koptserg/motion/README.md

# How to join:
### If device in FN(factory new) state:
1. Press and hold button (1) for 2-3 seconds, until device start flashing led
2. Wait, in case of successfull join, device will flash led 5 times
3. If join failed, device will flash led 3 times

### If device in a network:
1. Hold button (1) for 10 seconds, this will reset device to FN(factory new) status
2. Go to step 1 for FN device

# Hardware
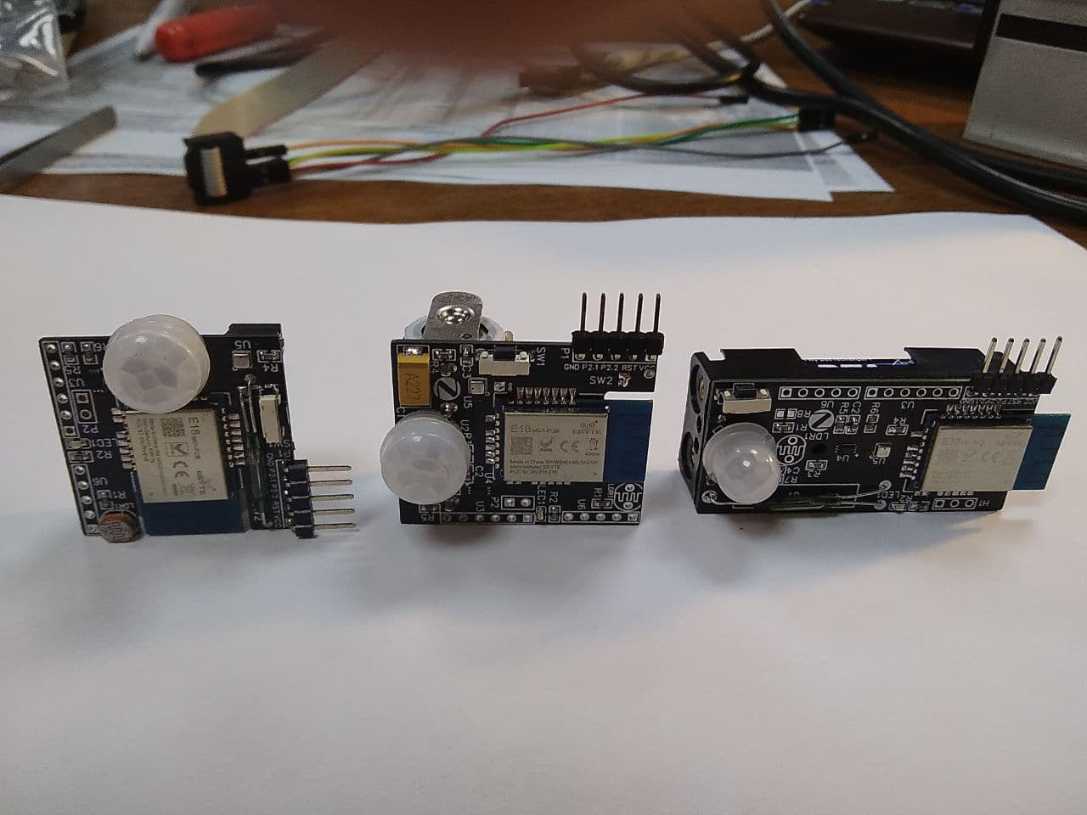
[picture p1: images/photo_2021-07-11_18-00-41.jpg]

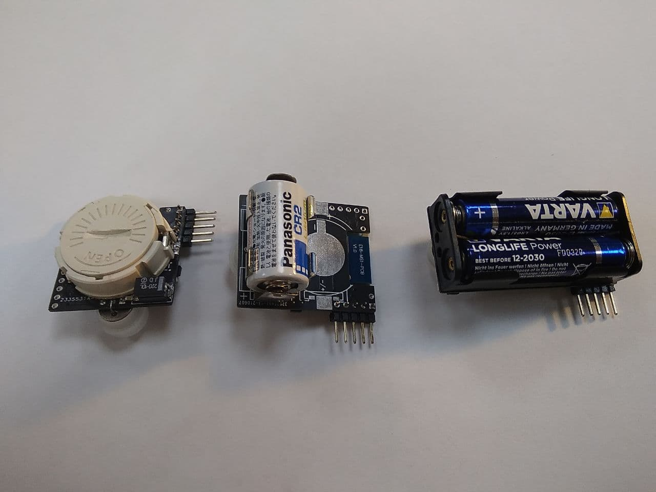
[picture p2: images/photo_2021-07-11_18-02-03.jpg]

### 2AAA version
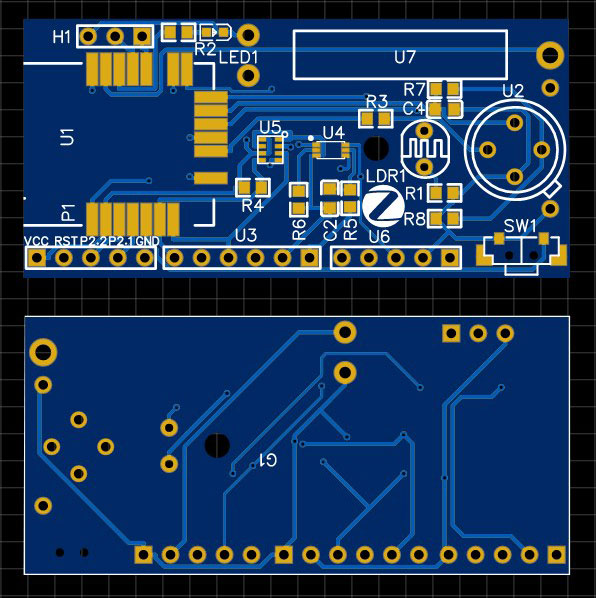
[picture p3: images/motion_AAA.jpg]

- Gerber, BOM, Scheme [2AAA](hardware/AAA/)

### CR2 version
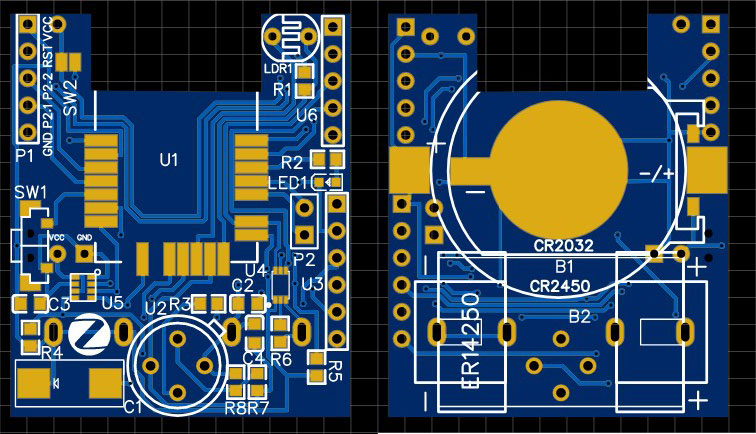
[picture p4: images/motion_CR2.jpg]

- Gerber, BOM, Scheme [CR2](hardware/CR2/)
- Attention! Do not use CR2032 and CR2450 with a motion sensor (AM312 / BS312), as at low battery voltage (<3v) false alarms occur.

# Firmwares
- Downalod from github [releases](https://github.com/koptserg/motion/releases)

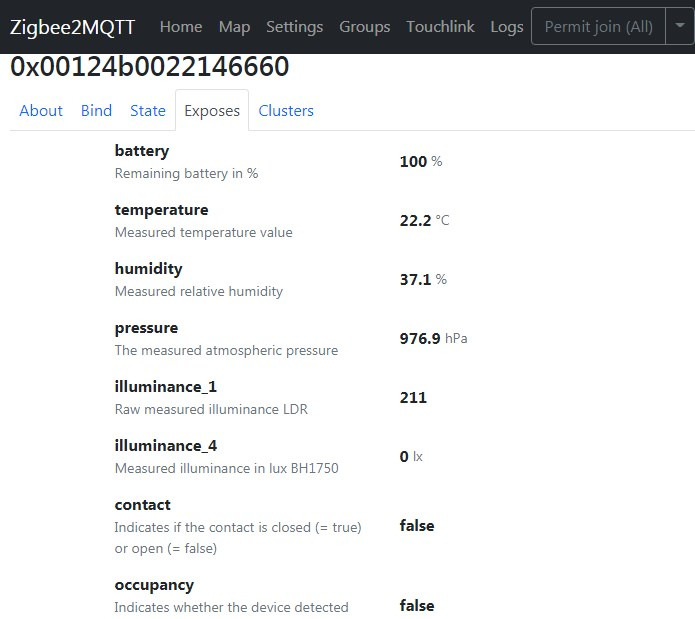
[picture p5: images/diyruz_motion_1.jpg]

- Settings can be changed without restarting zigbee2mqtt
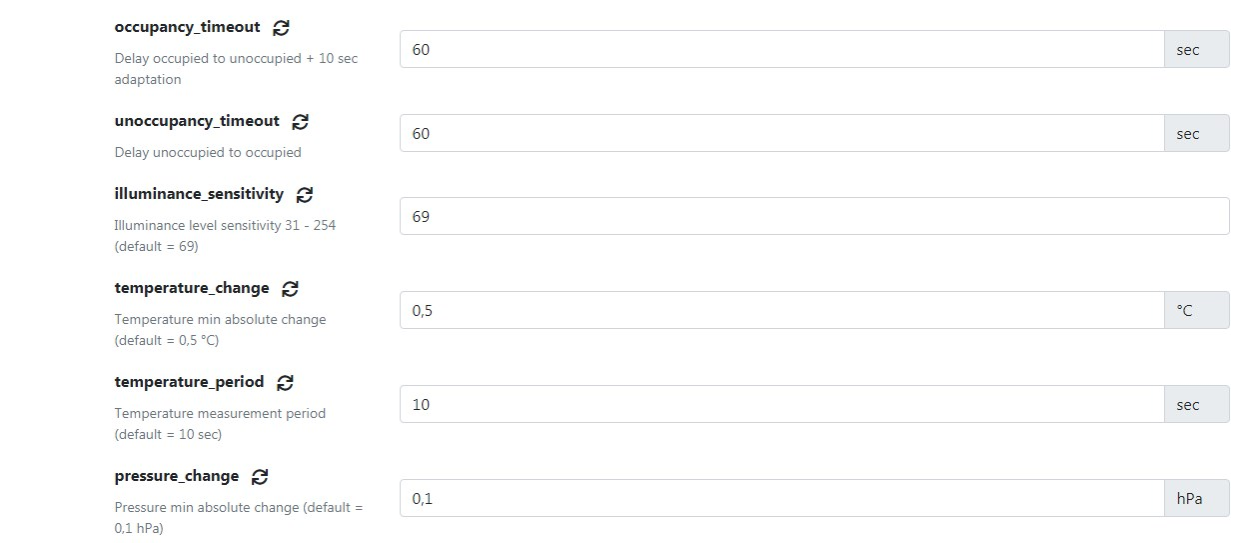
[picture p6: images/diyruz_motion_2.jpg]

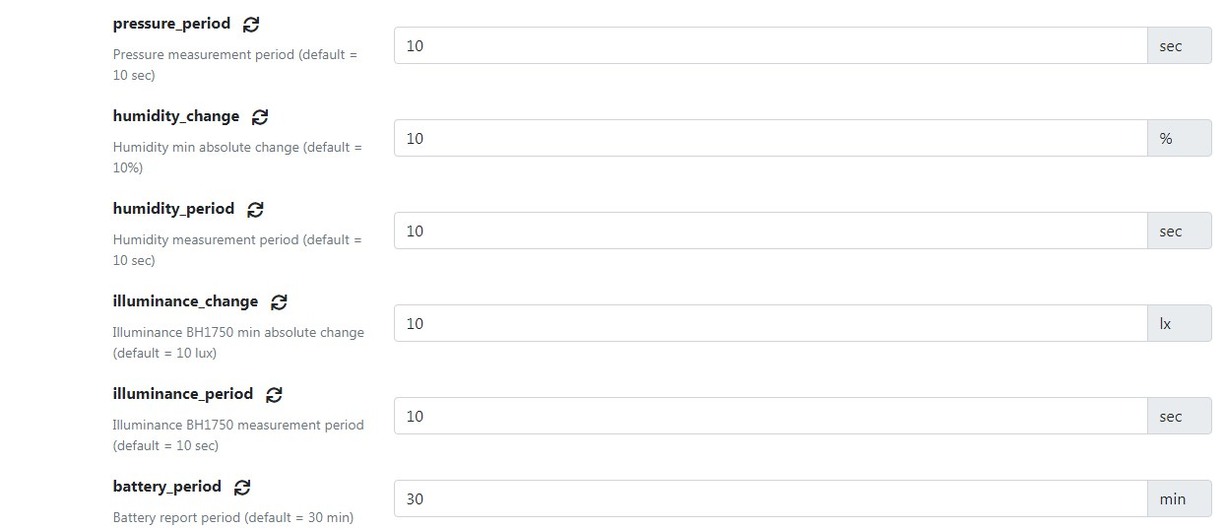
[picture p7: images/diyruz_motion_3.jpg]

- Bind
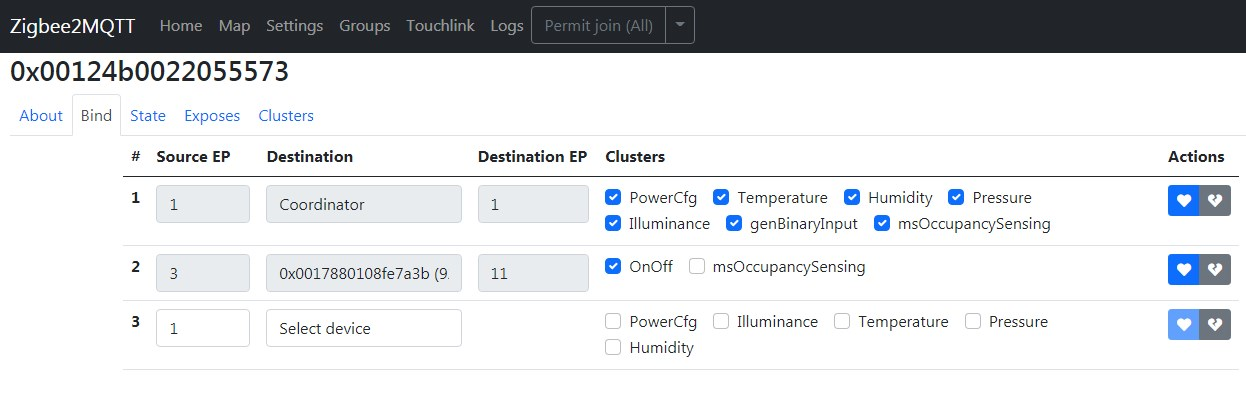
[picture p8: images/diyruz_motion_4.jpg]


- [Converters](converters/)

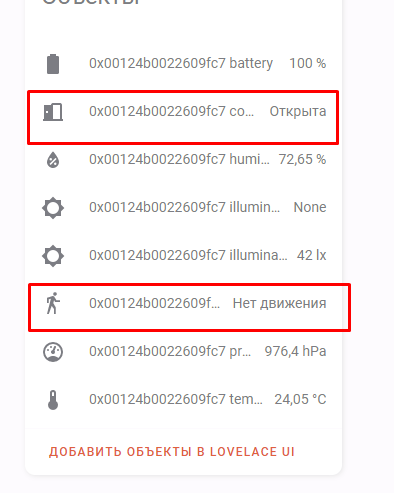
[picture p9: images/diyruz_motion_5.png]


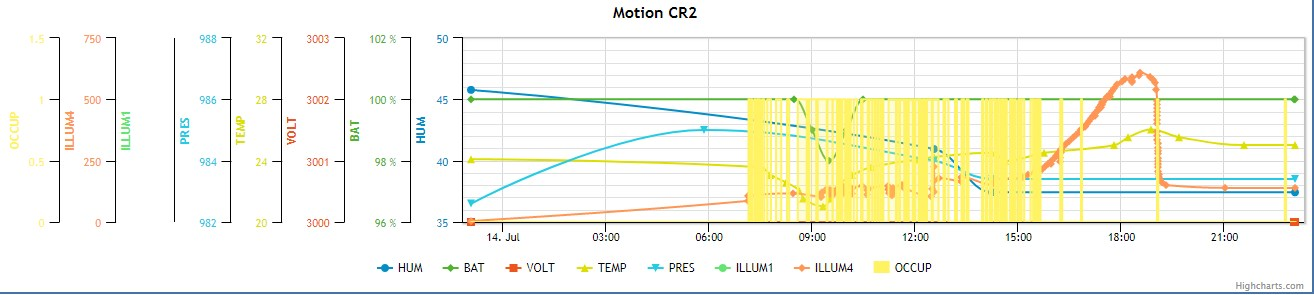
[picture p10: images/diyruz_motion_6.jpg]


# Thanks for the help
- firmware github [diyruz](https://github.com/diyruz) by [@anonymass](https://t.me/anonymass)
- hardware and testing by [@ring04](https://t.me/ring04)
- telegram channel [Zigdev](https://t.me/zigdev)
