koptserg/motion/images/diyruz_motion.jpg

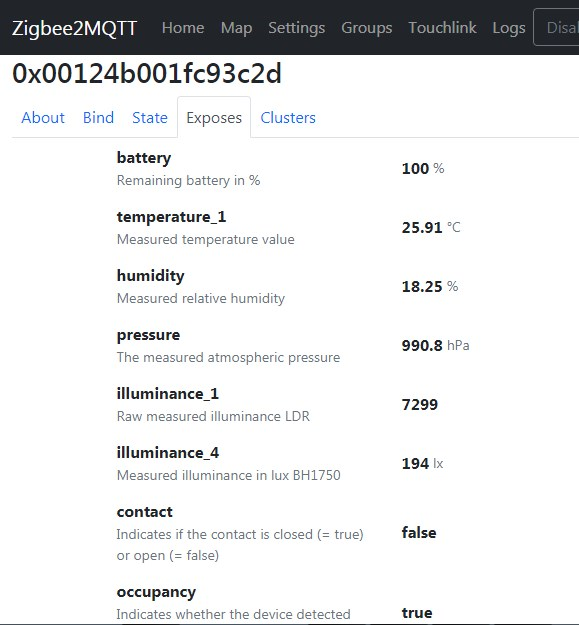
images/diyruz_motion.jpg
