koptserg/motion/images/diyruz_motion_sheme.jpg

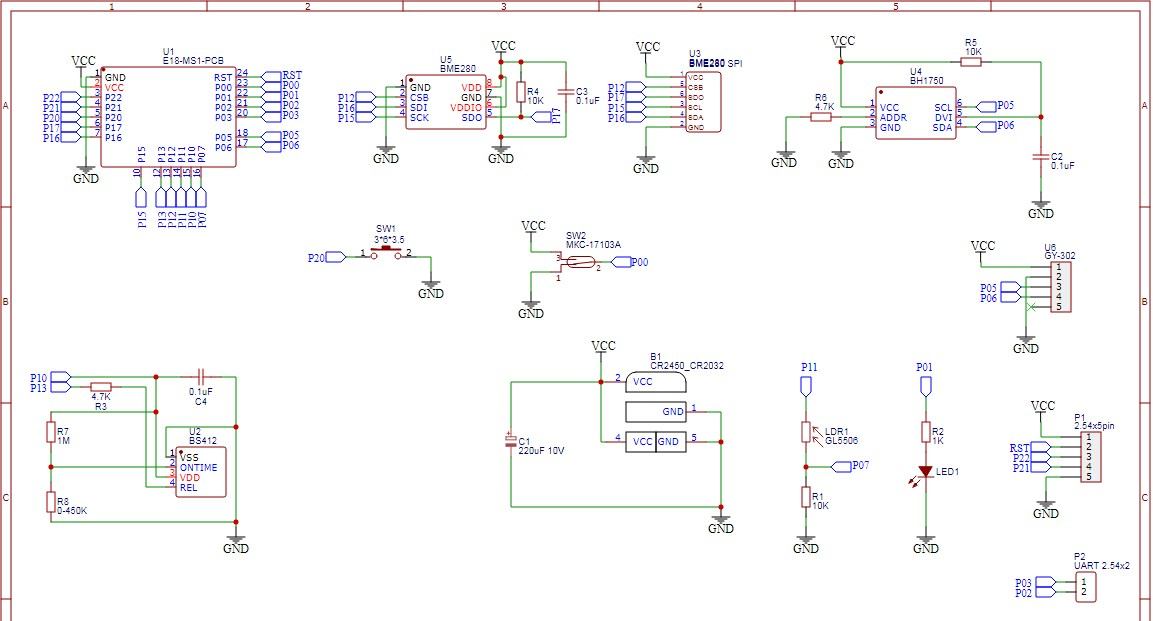
images/diyruz_motion_sheme.jpg
