koptserg/motion/hardware/CR2/BOM_zigbee_multipurpose_sensor_cr2450_v4.2_CR2_2021-07-14.csv

ID | Name | Designator | Footprint | Quantity | Manufacturer Part | Manufacturer | Supplier | Supplier Part | Price
1 | ER14250 BC-0301 AA/2 | B2 | BC-0301 ER14250 | 1 | BC-0301 |  | COMF |  |  | https://aliexpress.ru/item/33048790245.html
2 | МКС-17103А | SW2 | МКС-17103А-1 | 1 | МКС-17103А |  |  |  |  | https://aliexpress.ru/item/4000079749342.html
3 | 220uF 10V | C1 | EIA7343-31/D-W | 1 | TPSD227M010R0100 | AVX | LCSC | C8028 | 0.9161
4 | BS412 | U2 | SENSOR-TH_BS412 | 1 | BS412 | Senba Sensing Tech | LCSC | C410378 | 1.4066 | https://aliexpress.ru/item/1005002690374706.html https://aliexpress.ru/item/1005001706665504.html
5 | 0.1uF | C4,C3 | C0603 | 2 | 0603CG0R5C500NT | FH | LCSC | C1633 | 0.0044
6 | UART 2.54x2 | P2 | HDR-F-2.54_1X2 | 1 | 2.54x2pin | 2.54x2pin | LCSC | C49661 | 0.0336
7 | BH1750 | U4 | BH1750 SMT | 1 | BH1750FVI-TR | ROHM | LCSC | C78960 | 0.9433 | https://aliexpress.ru/item/4001146064858.html
8 | 0.1uF | C2 | C0603 | 1 | 0603CG0R5C500NT | FH | LCSC | C1633 | 0.0044
9 | 2.54x5pin | P1 | CC2530 TTL | 1 | 2.54x5pin | ReliaPro |  | C28952 | 0.0535
10 | GY-302 | U6 | BH1750 | 1 | 2.54x5pin | ReliaPro |  | C28952 | 0.0535
11 | 1K | R2 | R0603 | 1 | R0603RXX102XF10LTS | Shenzhen Eyang Tech Development | LCSC | C267568 | 0.0019
12 | 3*6*3.5 | SW1 | SW 3X6X2017MM SMT | 1 | 3*6*3.5 Side press High temperature | ReliaPro | LCSC | C37327 | 0.041 | https://aliexpress.ru/item/32816626751.html
13 | BME280 | U3 | BME280 | 1 | 2.54x6pin | 2.54x6pin
14 | 4.7K | R3,R6 | R0603 | 2 | R0603RXX472XJ10LTS | Shenzhen Eyang Tech Development | LCSC | C267283 | 0.0016
15 | BME280 | U5 | LGA-8_BME280 | 1 | BME280 | Bosch | LCSC | C92489 | 5.8852 | https://aliexpress.ru/item/1005002976067537.html
16 | E18-MS1-PCB | U1 | E18-MS1-PCB | 1 | E18-MS1-PCB | Chengdu Ebyte Elec Tech | LCSC | C97344 | 3.6733 | https://aliexpress.ru/item/4000185268806.html
17 | 10K | R1,R5,R4 | R0603 | 3 | AC0603FR-0710KL | YAGEO | LCSC | C116677 | 0.0022
18 | GL5506 | LDR1 | RES-PHOTO_CDS | 1 | GL5506(4-7K) | JCHL(Shenzhen Jing Chuang He Li Tech) | LCSC | C404970 | 0.047 | https://aliexpress.ru/item/32382661279.html
19 | 1M | R7 | R0603 | 1 | R0603RXX472XJ10LTS | Shenzhen Eyang Tech Development | LCSC | C267283 | 0.0016
20 | 0-450K | R8 | R0603 | 1 | R0603RXX472XJ10LTS | Shenzhen Eyang Tech Development | LCSC | C267283 | 0.0016
21 | HQ17-2102UBC | LED1 | LED0603-RD | 1 | HQ17-2102UBC | HARVATEK | LCSC | C154491 | 0.0256
22 | CR2450_CR2032 | B1 | CR2450_CR2032 | 1 | BS-8-1 | Q&J | LCSC | C70378 | 0.2722 | https://aliexpress.ru/item/33035019425.html https://aliexpress.ru/item/1005002322640119.html
