koptserg/motion/(threads)

Thread 1 (2021-05-05):

hardware

sergge1, 2021-05-05:
hello. your project is very interesting. what is abut hardware? have you built the PCB for this sproject?

koptserg, 2021-05-06:
The printed circuit board is designed for AM312, but gives false alarms on a dead 2450 battery. We will try sensors BS312 and BS412 or go to 2xAAA.

koptserg, 2021-05-06:
> hello. your project is very interesting. what is abut hardware? have you built the PCB for this sproject?

The printed circuit board is designed for AM312, but gives false alarms on a dead 2450 battery. We will try sensors BS312 and BS412 or go to 2xAAA.

koptserg, 2021-07-15:
> > hello. your project is very interesting. what is abut hardware? have you built the PCB for this sproject?
>
> The printed circuit board is designed for AM312, but gives false alarms on a dead 2450 battery. We will try sensors BS312 and BS412 or go to 2xAAA.

> hello. your project is very interesting. what is abut hardware? have you built the PCB for this sproject?

https://github.com/koptserg/motion/tree/main/hardware

Thread 3 (2022-08-10):

CPL file / Share

Ceda, 2022-08-10:
Hi, thank for nice project,
i would like order [CR2](https://github.com/koptserg/motion/blob/main/hardware/CR2) pcb from jlcpcb with assembly and CPL file is missing.
Can you generate CPL file for me, or share your project on easyeda/oshwlab profile.

Thx

Thread 4 (2022-09-21):

the homeassistant No change in the status of the door and window sensor

1292993725, 2022-09-21:

vring0, 2022-09-23:
Update converter in PR https://github.com/koptserg/motion/pull/5/

1292993725, 2022-09-26:
Thanks for your quick reply. My problem still exists with the new converter

Please let me describe the problem in detail：

I can see the changes of equipment status (doors and human bodies) in zigbee 2mqtt integrated by HA

However, in HA, the status of two sensors is unknown

It can be seen that the reading values of the two light sensors change normally

I don't know where it was set wrong

looking forward to your reply

cym9007, 2022-10-10:
Is it the temperature and atmospheric pressure? Are you sure the bm280 sensor is used?

vring0, 2022-10-11:
https://www.bosch-sensortec.com/products/environmental-sensors/humidity-sensors-bme280/#technical

Thread 6 (2022-10-03):

Firmware related issues

SOEST1, 2022-10-03:
The project is very good and supports you. My application scenario requires power supply. Can you help me compile a router version of firmware

koptserg, 2022-10-04:
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
Create a new configuration.
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
Change enddevice to router
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
Fix the condition
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
выключить
Turn off power save
Result DIYRuZ_Motion_Router.hex
https://github.com/koptserg/motion/tree/main/firmwares

SOEST1, 2022-10-04:
The first time I contacted zigbee program and IAR software, I tried to download 10.10, 10.40 and 10.30. Finally, I successfully opened the project. But when I compiled the program, I made many errors and handled some, but there were still many, which made me feel very helpless. Thank you for your help and guidance.

Thread 7 (2023-05-29):

Convertion from lux to Zigbee representation

turboproc, 2023-05-29:
Hi @koptserg, was building a similar sensor this weekend using a BH1750 sensor as well. When reading the Zigbee Cluster specification (section 4.2.2.2.1) I understood that the value to be send over the air should be something like 10.000 x log10(lux) + 1. Wondering whether this was missing in your code (might have overlooked) or whether you ommitted this on purpose.

Thread 8 (2023-12-12):

How do I compile?

pavel-baka, 2023-12-12:
I'm trying to build a device like this with Zigbee, but dont understand what I need to do. Is it possible to build this project using linux or do i need some special compilers?

koptserg, 2023-12-13:
The project can only be assembled IAR Embedded Workbench for 8051.
https://zigdevwiki.github.io/Begin/IAR_install/

Thread 9 (2024-01-20):

Zigbee2mqtt not working anymore in HA

andyg2002, 2024-01-20:
Hello, I am geetting error in HA Zigbee2mqtt at start since a few versions of Zigbee2mqtt:

`Zigbee2MQTT:error 2024-01-20 17:21:19: Failed to load external converter file 'DIYRuZ_Motion_HA.js' (Cannot read properties of undefined (reading 'battery'))
Zigbee2MQTT:error 2024-01-20 17:21:19: Probably there is a syntax error in the file or the external converter is not compatible with the current Zigbee2MQTT version
Zigbee2MQTT:error 2024-01-20 17:21:19: Note that external converters are not meant for long term usage, it's meant for local testing after which a pull request should be created to add out-of-the-box support for the device`

It worked in the past but now I am always getting this error. All other Zigbee-devices are working well, it seems that its only related to this Coverter.
When i manually add the Extension I am also getting following error:

```

Cannot read properties of undefined (reading 'battery')

Request
'zigbee2mqtt/bridge/request/extension/save' failed with error: 'Cannot read properties of undefined (reading 'battery')'

```
Is there any solution for that?
Thank you in advance.
