koptserg/motion/hardware/AAA/zigbee_pir_share_AAA.pdf

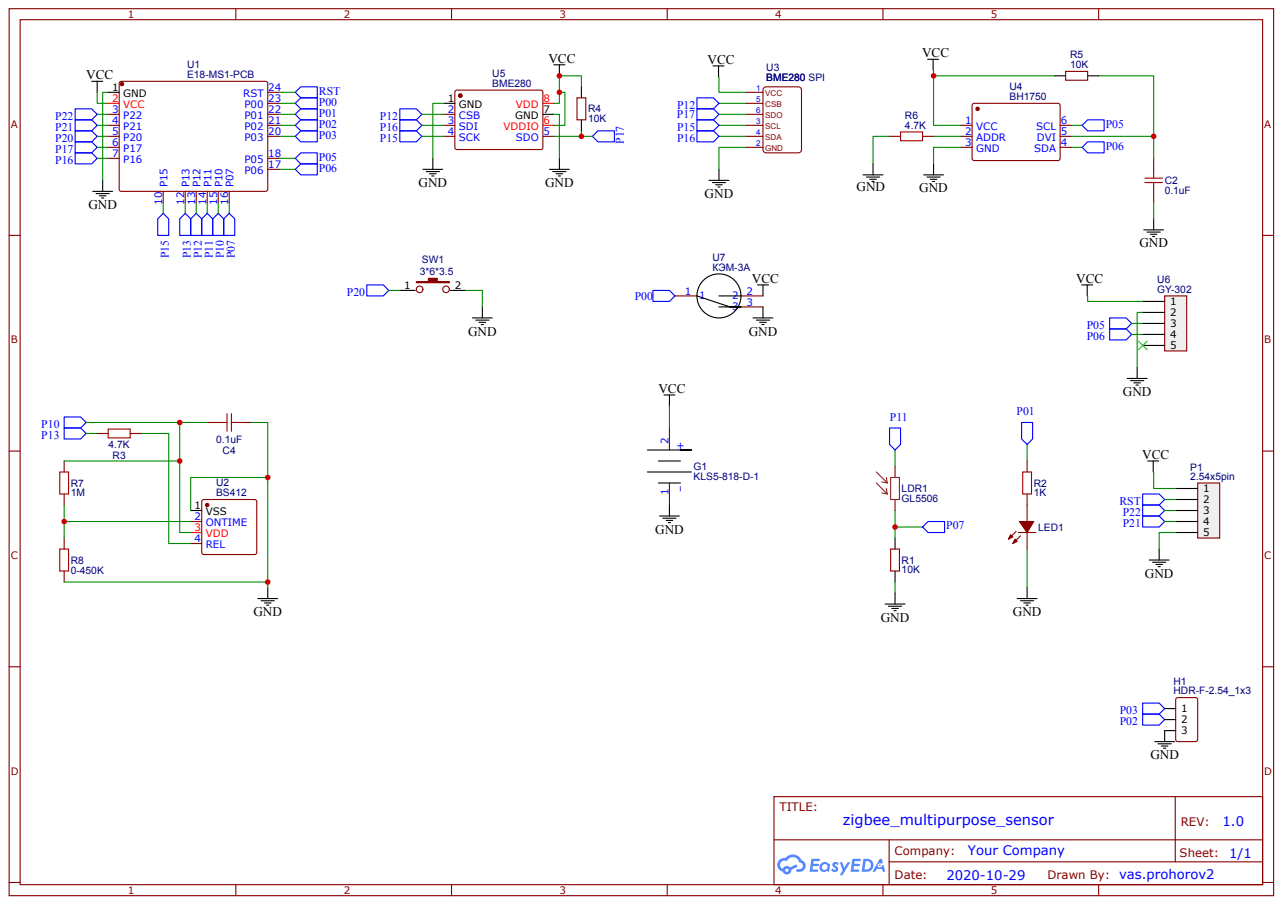
[picture p13: page 1]
