koptserg/motion/hardware/CR2/zigbee_pir_share_CR2.pdf

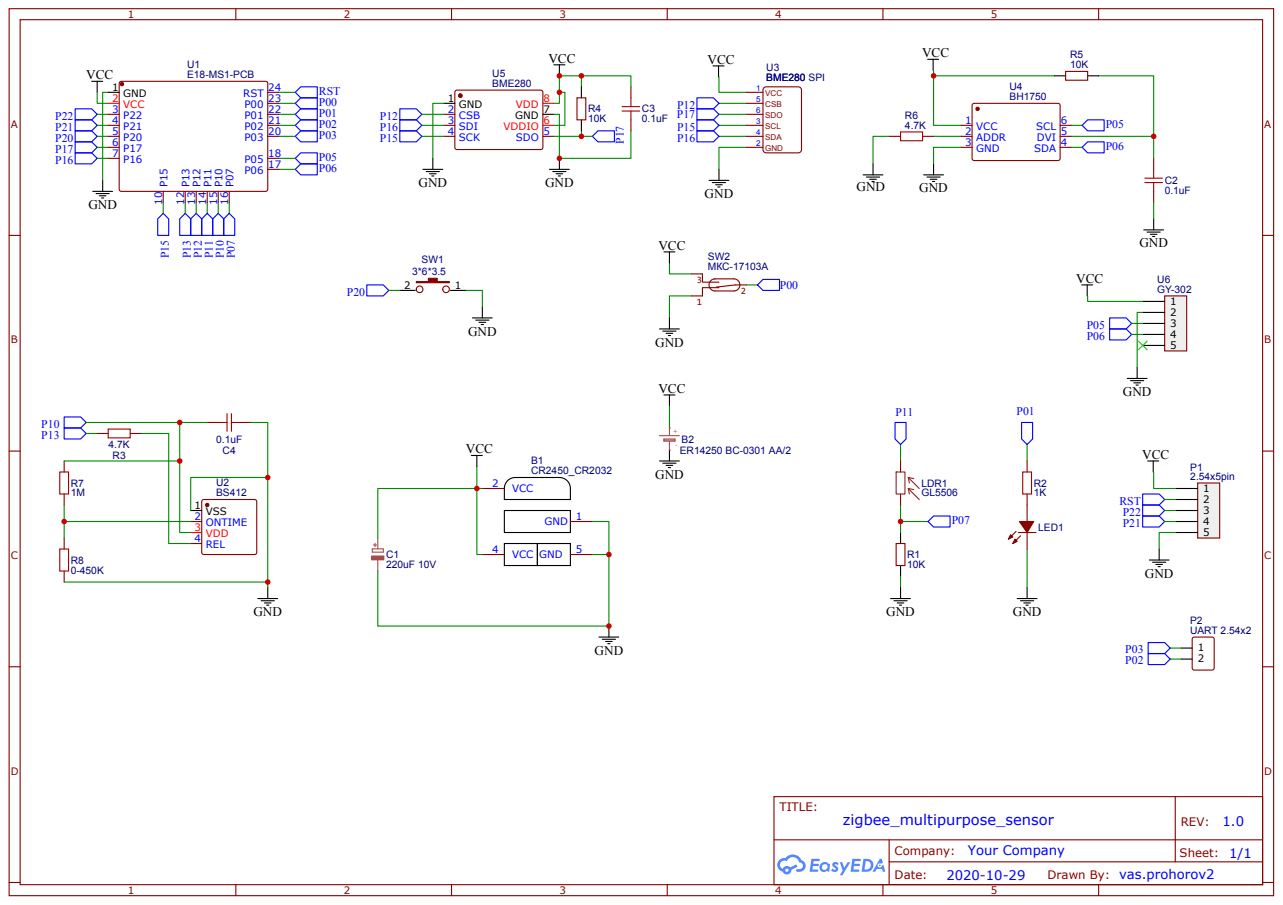
[picture p14: page 1]
