koptserg/motion/Source/zcl_app.c

#include "AF.h"
#include "OSAL.h"
#include "OSAL_Clock.h"
#include "OSAL_PwrMgr.h"
#include "ZComDef.h"
#include "ZDApp.h"
#include "ZDNwkMgr.h"
#include "ZDObject.h"
#include "math.h"

#include "nwk_util.h"
#include "zcl.h"
#include "zcl_app.h"
#include "zcl_diagnostic.h"
#include "zcl_general.h"
#include "zcl_lighting.h"
#include "zcl_ms.h"

#include "bdb.h"
#include "bdb_interface.h"
#include "gp_interface.h"

#include "Debug.h"

#include "OnBoard.h"

/* HAL */
#include "hal_adc.h"
#include "hal_drivers.h"
#include "hal_i2c.h"
#include "hal_key.h"
#include "hal_led.h"

#include "bme280spi.h"
#include "bh1750.h"
#include "battery.h"
#include "commissioning.h"
#include "factory_reset.h"
#include "utils.h"
#include "version.h"

/*********************************************************************
 * MACROS
 */
#define HAL_KEY_P0_EDGE_BITS HAL_KEY_BIT0

#define HAL_KEY_P1_EDGE_BITS (HAL_KEY_BIT1 | HAL_KEY_BIT2)

#define HAL_KEY_CODE_RELEASE_KEY HAL_KEY_CODE_NOKEY

#define IO_PUP_BH1750()                        \
    do {                                       \
        IO_PUD_PORT(OCM_CLK_PORT, IO_PUP);     \
        IO_PUD_PORT(OCM_DATA_PORT, IO_PUP);    \
    } while (0) 
 

#define IO_PDN_BH1750()                     \
    do {                                        \
        IO_PUD_PORT(OCM_CLK_PORT, IO_PDN);      \
        IO_PUD_PORT(OCM_DATA_PORT, IO_PDN);     \
    } while (0)

/*********************************************************************
 * CONSTANTS
 */

/*********************************************************************
 * TYPEDEFS
 */

/*********************************************************************
 * GLOBAL VARIABLES
 */

extern bool requestNewTrustCenterLinkKey;
byte zclApp_TaskID;

/*********************************************************************
 * GLOBAL FUNCTIONS
 */

/*********************************************************************
 * LOCAL VARIABLES
 */

static uint8 currentSensorsReadingPhase = 0;

uint8 report = 0;
uint8 power = 0;
bool bmeDetect = 0;
bool LumDetect = 0;
uint8 contDetect = 0;
uint8 motionDetect = 0;
uint8 bh1750Detect = 0;
uint8 BH1750_mode = ONE_TIME_HIGH_RES_MODE;
uint8 smart_number = 1; // smart number period occupancy_timeout

uint16 temp_IlluminanceSensor_MeasuredValue;
uint16 temp_bh1750IlluminanceSensor_MeasuredValue;
uint16 temp_Temperature_Sensor_MeasuredValue;
uint16 temp_PressureSensor_MeasuredValue;
uint16 temp_HumiditySensor_MeasuredValue;

afAddrType_t inderect_DstAddr = {.addrMode = (afAddrMode_t)AddrNotPresent, .endPoint = 0, .addr.shortAddr = 0};

/*********************************************************************
 * LOCAL FUNCTIONS
 */
static void zclApp_HandleKeys(byte shift, byte keys);
static void zclApp_Report(void);

static void zclApp_BasicResetCB(void);
static void zclApp_RestoreAttributesFromNV(void);
static void zclApp_SaveAttributesToNV(void);
static void zclApp_StopReloadTimer(void);
static void zclApp_StartReloadTimer(void);

static ZStatus_t zclApp_ReadWriteAuthCB(afAddrType_t *srcAddr, zclAttrRec_t *pAttr, uint8 oper);

static void zclApp_ReadSensors(void);
static void zclApp_ReadBME280Temperature(void);
static void zclApp_ReadBME280Pressure(void);
static void zclApp_ReadBME280Humidity(void);
static void zclApp_ReadLumosity(void);
static void zclApp_bh1750StartLumosity(void);
static void zclApp_bh1750ReadLumosity(void);
static void zclApp_bh1750setMTreg(void);
static void zclApp_MagnetPullUpDown(void);
static void zclApp_MotionPullUpDown(void);

/*********************************************************************
 * ZCL General Profile Callback table
 */
static zclGeneral_AppCallbacks_t zclApp_CmdCallbacks = {
    zclApp_BasicResetCB, // Basic Cluster Reset command
    NULL, // Identify Trigger Effect command
    NULL, // On/Off cluster commands
    NULL, // On/Off cluster enhanced command Off with Effect
    NULL, // On/Off cluster enhanced command On with Recall Global Scene
    NULL, // On/Off cluster enhanced command On with Timed Off
    NULL, // RSSI Location command
    NULL  // RSSI Location Response command
};

void zclApp_MagnetPullUpDown(void) {
    if (zclApp_Magnet == 1){
      P2INP &= ~HAL_KEY_BIT5; // pull up
      MicroWait(50);
      PICTL |= HAL_KEY_P0_EDGE_BITS; // set falling edge on port
    } else {
      P2INP |= HAL_KEY_BIT5; // pull down
      MicroWait(50);
      PICTL &= ~(HAL_KEY_P0_EDGE_BITS);     
    }
}

void zclApp_MotionPullUpDown(void) {
    if (zclApp_Occupied == 1){
      P2INP &= ~HAL_KEY_BIT6; // pull up
      MicroWait(50);
      PICTL |= HAL_KEY_P1_EDGE_BITS; // set falling edge on port
    } else {
      P2INP |= HAL_KEY_BIT6; // pull down
      MicroWait(50);
      PICTL &= ~(HAL_KEY_P1_EDGE_BITS);     
    }
}

void zclApp_Init(byte task_id) {
    zclApp_RestoreAttributesFromNV();
      
    IO_IMODE_PORT_PIN(LUMOISITY_PORT, LUMOISITY_PIN, IO_TRI); // tri state p0.7 (lumosity pin)
    HAL_TURN_ON_LED4(); // p1.1 ON
    zclApp_ReadLumosity();
    HAL_TURN_OFF_LED4(); // p1.1 OFF
    if (zclApp_IlluminanceSensor_MeasuredValue > 1000){
      LumDetect = 1;
    } else {
      IO_IMODE_PORT_PIN(LUMOISITY_PORT, LUMOISITY_PIN, IO_PUD); // Pullup/pulldn input p0.7 (lumosity pin)
      LumDetect = 0;      
    }

    LREP("P0_0 %d\r\n", P0_0);
    contDetect = P0_0;
    zclApp_Magnet_OnOff = contDetect;
    zclApp_Magnet = contDetect;
    zclApp_MagnetPullUpDown();
    
    P1SEL &= ~BV(0); // Set P1_0 to GPIO
    P1DIR |= BV(0); // P1_0 output
    P1 &= ~BV(0);   // power off DD //--
    motionDetect = P1_3;
    zclApp_Occupied_OnOff = motionDetect;
    zclApp_Occupied = motionDetect;
    zclApp_MotionPullUpDown();
//    P1DIR &= ~BV(0); // P1_0 input //--
//    P1 |=  BV(0);   // power on DD
        
    bmeDetect = BME280Init();
    
    HalI2CInit();
    IO_PUP_BH1750();
    bh1750Detect = bh1750_init(BH1750_mode);
    zclApp_bh1750setMTreg(); 
    IO_PDN_BH1750();    
    // this is important to allow connects throught routers
    // to make this work, coordinator should be compiled with this flag #define TP2_LEGACY_ZC
    requestNewTrustCenterLinkKey = FALSE;

    zclApp_TaskID = task_id;

    zclGeneral_RegisterCmdCallbacks(1, &zclApp_CmdCallbacks);
    zcl_registerAttrList(zclApp_FirstEP.EndPoint, zclApp_AttrsFirstEPCount, zclApp_AttrsFirstEP);
    bdb_RegisterSimpleDescriptor(&zclApp_FirstEP);
    zcl_registerReadWriteCB(zclApp_FirstEP.EndPoint, NULL, zclApp_ReadWriteAuthCB);

    zcl_registerAttrList(zclApp_SecondEP.EndPoint, zclApp_AttrsSecondEPCount, zclApp_AttrsSecondEP);
    bdb_RegisterSimpleDescriptor(&zclApp_SecondEP);
    zcl_registerReadWriteCB(zclApp_SecondEP.EndPoint, NULL, zclApp_ReadWriteAuthCB);
    
    zcl_registerAttrList(zclApp_ThirdEP.EndPoint, zclApp_AttrsThirdEPCount, zclApp_AttrsThirdEP);
    bdb_RegisterSimpleDescriptor(&zclApp_ThirdEP);
    zcl_registerReadWriteCB(zclApp_ThirdEP.EndPoint, NULL, zclApp_ReadWriteAuthCB);
    
    zcl_registerAttrList(zclApp_FourthEP.EndPoint, zclApp_AttrsFourthEPCount, zclApp_AttrsFourthEP);
    bdb_RegisterSimpleDescriptor(&zclApp_FourthEP);   
    zcl_registerReadWriteCB(zclApp_FourthEP.EndPoint, NULL, zclApp_ReadWriteAuthCB);

    zcl_registerForMsg(zclApp_TaskID);

    // Register for all key events - This app will handle all key events
    RegisterForKeys(zclApp_TaskID);
    LREP("Started build %s \r\n", zclApp_DateCodeNT);

//    osal_start_reload_timer(zclApp_TaskID, APP_REPORT_EVT, APP_REPORT_DELAY);   
    zclApp_StartReloadTimer();
}

uint16 zclApp_event_loop(uint8 task_id, uint16 events) {
    afIncomingMSGPacket_t *MSGpkt;
    devStates_t zclApp_NwkState; //---
    
    (void)task_id; // Intentionally unreferenced parameter
    if (events & SYS_EVENT_MSG) {
        while ((MSGpkt = (afIncomingMSGPacket_t *)osal_msg_receive(zclApp_TaskID))) {
            switch (MSGpkt->hdr.event) {
            case KEY_CHANGE:
                zclApp_HandleKeys(((keyChange_t *)MSGpkt)->state, ((keyChange_t *)MSGpkt)->keys);
                
                break;
            case ZDO_STATE_CHANGE:
                zclApp_NwkState = (devStates_t)(MSGpkt->hdr.status);
                LREP("NwkState=%d\r\n", zclApp_NwkState);
                if (zclApp_NwkState == DEV_END_DEVICE) {
                  IEN2 |= HAL_KEY_BIT4; // enable port1 int
                  P1DIR |=  BV(0); // P1_0 output
                  P1 |=  BV(0);   // power on DD
                } else {
//                  IEN2 &= ~HAL_KEY_BIT4; // disable port1 int
//                  P1 &= ~BV(0);   // power off DD //--
//                  P1DIR &= ~BV(0); // P1_0 input
                }
                break;
            case ZCL_INCOMING_MSG:
                if (((zclIncomingMsg_t *)MSGpkt)->attrCmd) {
                    osal_mem_free(((zclIncomingMsg_t *)MSGpkt)->attrCmd);
                }
                break;

            default:
                break;
            }
            // Release the memory
            osal_msg_deallocate((uint8 *)MSGpkt);
        }
        // return unprocessed events
        return (events ^ SYS_EVENT_MSG);
    }
    
    if (events & APP_REPORT_LDR_EVT) {
        LREPMaster("APP_REPORT_LDR_EVT\r\n");
        report = 0;
        HAL_TURN_ON_LED4(); // p1.1 ON
        zclApp_ReadLumosity();
        HAL_TURN_OFF_LED4(); // p1.1 OFF

        return (events ^ APP_REPORT_LDR_EVT);
    }
    
    if (events & APP_REPORT_TEMPERATURE_EVT) {
        LREPMaster("APP_REPORT_TEMPERATURE_EVT\r\n");
        report = 0;
        zclApp_ReadBME280Temperature();
        
        return (events ^ APP_REPORT_TEMPERATURE_EVT);
    }
    
    if (events & APP_REPORT_PRESSURE_EVT) {
        LREPMaster("APP_REPORT_PRESSURE_EVT\r\n");
        report = 0;
        zclApp_ReadBME280Pressure();
   
        return (events ^ APP_REPORT_PRESSURE_EVT);
    }
    
    if (events & APP_REPORT_HUMIDITY_EVT) {
        LREPMaster("APP_REPORT_HUMIDITY_EVT\r\n");
        report = 0;
        zclApp_ReadBME280Humidity();
   
        return (events ^ APP_REPORT_HUMIDITY_EVT);
    }
    
    if (events & APP_REPORT_ILLUMINANCE_EVT) {
        LREPMaster("APP_REPORT_ILLUMINANCE_EVT\r\n");       
        report = 0;
        zclApp_bh1750StartLumosity();
           
        return (events ^ APP_REPORT_ILLUMINANCE_EVT);
    }
    if (events & APP_REPORT_BATTERY_EVT) {
        LREPMaster("APP_REPORT_BATTERY_EVT\r\n");
        report = 0;
        zclBattery_Report();

        return (events ^ APP_REPORT_BATTERY_EVT);
    }
    
    if (events & APP_REPORT_EVT) {
        LREPMaster("APP_REPORT_EVT\r\n");
        report = 1;
        zclApp_Report();
        return (events ^ APP_REPORT_EVT);
    }

    if (events & APP_READ_SENSORS_EVT) {
        LREPMaster("APP_READ_SENSORS_EVT\r\n");
        zclApp_ReadSensors();
        return (events ^ APP_READ_SENSORS_EVT);
    }
        
    if (events & APP_MOTION_ON_EVT) {
        LREPMaster("APP_MOTION_ON_EVT\r\n");
        P1 &= ~BV(0);   // power off motion
//        P1DIR &= ~BV(0); // P1_0 input
        osal_start_timerEx(zclApp_TaskID, APP_MOTION_DELAY_EVT, (uint32)zclApp_Config.PirOccupiedToUnoccupiedDelay * 1000);
        LREPMaster("START_DELAY\r\n");
        //report
        zclApp_Occupied = 1;
        zclApp_Occupied_OnOff = 1; 
        zclGeneral_SendOnOff_CmdOn(zclApp_ThirdEP.EndPoint, &inderect_DstAddr, TRUE, bdb_getZCLFrameCounter());
        bdb_RepChangedAttrValue(zclApp_ThirdEP.EndPoint, OCCUPANCY, ATTRID_MS_OCCUPANCY_SENSING_CONFIG_OCCUPANCY);
        
        return (events ^ APP_MOTION_ON_EVT);
    }
    
    if (events & APP_MOTION_OFF_EVT) {
        LREPMaster("APP_MOTION_OFF_EVT\r\n");
#ifdef SMART
        if (smart_number == 2) {
          smart_number = smart_number - 1;
#endif
          //report 
          zclApp_Occupied = 0;
          zclApp_Occupied_OnOff = 0;
          zclGeneral_SendOnOff_CmdOff(zclApp_ThirdEP.EndPoint, &inderect_DstAddr, TRUE, bdb_getZCLFrameCounter());
          bdb_RepChangedAttrValue(zclApp_ThirdEP.EndPoint, OCCUPANCY, ATTRID_MS_OCCUPANCY_SENSING_CONFIG_OCCUPANCY);
#ifdef SMART          
        } else {
          smart_number = smart_number - 1;
          osal_start_timerEx(zclApp_TaskID, APP_MOTION_OFF_EVT, (uint32)zclApp_Config.PirUnoccupiedToOccupiedDelay * 1000);
        }
#endif
        
        return (events ^ APP_MOTION_OFF_EVT);
    }
    
    if (events & APP_MOTION_DELAY_EVT) {
        LREPMaster("APP_MOTION_DELAY_EVT\r\n");
        power = 2;       
        P1DIR |=  BV(0); // P1_0 output
        P1 |=  BV(0);   // power on motion
#ifdef SMART
        if (smart_number < 15) {
          smart_number = smart_number + 1;
        }
#endif
        
        return (events ^ APP_MOTION_DELAY_EVT);
    }
    
    if (events & APP_CONTACT_DELAY_EVT) {
        LREPMaster("APP_CONTACT_DELAY_EVT\r\n");

        if (zclApp_Magnet_OnOff == 1){
          zclGeneral_SendOnOff_CmdOn(zclApp_SecondEP.EndPoint, &inderect_DstAddr, TRUE, bdb_getZCLFrameCounter());
          bdb_RepChangedAttrValue(zclApp_SecondEP.EndPoint, BINARY_INPUT, ATTRID_GEN_BINARY_INPUT_PRESENTVALUE);
        }
        if (zclApp_Magnet_OnOff == 0){
          zclGeneral_SendOnOff_CmdOff(zclApp_SecondEP.EndPoint, &inderect_DstAddr, TRUE, bdb_getZCLFrameCounter());
          bdb_RepChangedAttrValue(zclApp_SecondEP.EndPoint, BINARY_INPUT, ATTRID_GEN_BINARY_INPUT_PRESENTVALUE);
        }

        return (events ^ APP_CONTACT_DELAY_EVT);
    }
    
    if (events & APP_BH1750_DELAY_EVT) {
        LREPMaster("APP_BH1750_DELAY_EVT\r\n");
        zclApp_bh1750ReadLumosity();
        
        return (events ^ APP_BH1750_DELAY_EVT);
    }
    
    if (events & APP_SAVE_ATTRS_EVT) {
        LREPMaster("APP_SAVE_ATTRS_EVT\r\n");
        zclApp_SaveAttributesToNV();
        
        return (events ^ APP_SAVE_ATTRS_EVT);
    }

    // Discard unknown events
    return 0;
}

static void zclApp_HandleKeys(byte portAndAction, byte keyCode) {
    LREP("zclApp_HandleKeys portAndAction=0x%X keyCode=0x%X\r\n", portAndAction, keyCode);
    zclFactoryResetter_HandleKeys(portAndAction, keyCode);
    zclCommissioning_HandleKeys(portAndAction, keyCode);
    if (portAndAction & HAL_KEY_PRESS) {
        LREPMaster("Key press\r\n");
    }

    bool contact = portAndAction & HAL_KEY_PRESS ? TRUE : FALSE;
    uint8 endPoint = 0;
    if (portAndAction & HAL_KEY_PORT0) {
        LREPMaster("Key press PORT0\r\n");
//        P2INP ^= HAL_KEY_BIT5; // flip pull up/down
        osal_start_timerEx(zclApp_TaskID, APP_CONTACT_DELAY_EVT, 100); //adaptive contact
//        HalLedSet(HAL_LED_1, HAL_LED_MODE_BLINK);
        if (contact){
          P2INP &= ~HAL_KEY_BIT5; // pull up
          zclApp_Magnet_OnOff = contact;
          zclApp_Magnet = contact;

        } else {
          P2INP |= HAL_KEY_BIT5; // pull down
          zclApp_Magnet_OnOff = contact;
          zclApp_Magnet = contact;

        }
        
    } else if (portAndAction & HAL_KEY_PORT1) {     
        LREPMaster("Key press PORT1\r\n");
//          P2INP ^= HAL_KEY_BIT6; // flip down/up
        if (!contact) {
          P2INP |= HAL_KEY_BIT6;  // pull down
        } else {
          P2INP &= ~HAL_KEY_BIT6; // pull up
        }
//        HalLedSet(HAL_LED_1, HAL_LED_MODE_BLINK);
        if (power == 0){
          if (contact) {
            osal_start_timerEx(zclApp_TaskID, APP_MOTION_ON_EVT, 100);
            osal_stop_timerEx(zclApp_TaskID, APP_MOTION_OFF_EVT);
            osal_clear_event(zclApp_TaskID, APP_MOTION_OFF_EVT);
            
          }
        } else {
          if (power == 1){
            //end adaptive motion
            osal_start_timerEx(zclApp_TaskID, APP_MOTION_OFF_EVT, (uint32)zclApp_Config.PirUnoccupiedToOccupiedDelay * 1000); 
          }
          power = power - 1;
        }
        LREP("power=%d\r\n", power);
     } else if (portAndAction & HAL_KEY_PORT2) {
       LREPMaster("Key press PORT2\r\n");
       if (contact) {
          HalLedSet(HAL_LED_1, HAL_LED_MODE_BLINK);
//          IEN2 &= ~HAL_KEY_BIT4; // disable port1 int
          osal_start_timerEx(zclApp_TaskID, APP_REPORT_EVT, 200);
       } else {
//          IEN2 |= HAL_KEY_BIT4; // enable port1 int
       }
     }
     LREP("contact=%d endpoint=%d\r\n", contact, endPoint);
     uint16 alarmStatus = 0;
     if (!contact) {
        alarmStatus |= BV(0);
     } 
}

static void zclApp_ReadSensors(void) {
    LREP("currentSensorsReadingPhase %d\r\n", currentSensorsReadingPhase);
    /**
     * FYI: split reading sensors into phases, so single call wouldn't block processor
     * for extensive ammount of time
     * */
  if (report == 1) {
    switch (currentSensorsReadingPhase++) {
    case 0:
//        HalLedSet(HAL_LED_1, HAL_LED_MODE_BLINK);    
      zclBattery_Report();      
        break;
    case 1:
      if (LumDetect == 1){
        HAL_TURN_ON_LED4(); // p1.1 ON
        zclApp_ReadLumosity();
        HAL_TURN_OFF_LED4(); // p1.1 OFF
      }
          break;
    case 2:
      if (bmeDetect == 1){
          zclApp_ReadBME280Temperature();
      }
        break;
    case 3:
      if (bmeDetect == 1){
          zclApp_ReadBME280Pressure();
      }
        break;
    case 4:
      if (bmeDetect == 1){
          zclApp_ReadBME280Humidity();
      }
        break;
    case 5:
      if (bh1750Detect == 1){
        zclApp_bh1750StartLumosity();
      }      
        break;
    case 6:
        bdb_RepChangedAttrValue(zclApp_SecondEP.EndPoint, BINARY_INPUT, ATTRID_GEN_BINARY_INPUT_PRESENTVALUE);      
        break;
    default:
        osal_stop_timerEx(zclApp_TaskID, APP_READ_SENSORS_EVT);
        osal_clear_event(zclApp_TaskID, APP_READ_SENSORS_EVT);
        currentSensorsReadingPhase = 0;
        break;
    }
  }

}

static void zclApp_ReadLumosity(void) {
//    zclApp_IlluminanceSensor_MeasuredValueRawAdc = adcReadSampled(LUMOISITY_PIN, HAL_ADC_RESOLUTION_14, HAL_ADC_REF_AVDD, 5);
//    zclApp_IlluminanceSensor_MeasuredValue = zclApp_IlluminanceSensor_MeasuredValueRawAdc;
    zclApp_IlluminanceSensor_MeasuredValue = adcReadSampled(LUMOISITY_PIN, HAL_ADC_RESOLUTION_14, HAL_ADC_REF_AVDD, 5);
  
    uint16 illum = 0;
    if (temp_IlluminanceSensor_MeasuredValue > zclApp_IlluminanceSensor_MeasuredValue){
      illum = (temp_IlluminanceSensor_MeasuredValue - zclApp_IlluminanceSensor_MeasuredValue);
    } else {
      illum = (zclApp_IlluminanceSensor_MeasuredValue - temp_IlluminanceSensor_MeasuredValue);
    }
    if (illum > 100 || report == 1){
      temp_IlluminanceSensor_MeasuredValue = zclApp_IlluminanceSensor_MeasuredValue;
      bdb_RepChangedAttrValue(zclApp_FirstEP.EndPoint, ILLUMINANCE, ATTRID_MS_ILLUMINANCE_MEASURED_VALUE);
    }
    LREP("IlluminanceSensor_MeasuredValue value=%d\r\n", zclApp_IlluminanceSensor_MeasuredValue);
}

static void zclApp_bh1750StartLumosity(void) {
        IO_PUP_BH1750();
        bh1850_Write(BH1750_POWER_ON);        
        bh1850_Write(BH1750_mode);
        IO_PDN_BH1750();
        zclApp_MagnetPullUpDown();
   
        if (BH1750_mode == CONTINUOUS_LOW_RES_MODE || BH1750_mode == ONE_TIME_LOW_RES_MODE) {
          osal_start_timerEx(zclApp_TaskID, APP_BH1750_DELAY_EVT, 30);
        } else {
          osal_start_timerEx(zclApp_TaskID, APP_BH1750_DELAY_EVT, 180);
        }
}

static void zclApp_bh1750ReadLumosity(void) {
    IO_PUP_BH1750();
    zclApp_bh1750IlluminanceSensor_MeasuredValue = (uint16)(bh1850_Read());
    bh1850_PowerDown();
    IO_PDN_BH1750();
    zclApp_MagnetPullUpDown();
        
    uint16 illum = 0;
    if (temp_bh1750IlluminanceSensor_MeasuredValue > zclApp_bh1750IlluminanceSensor_MeasuredValue){
      illum = (temp_bh1750IlluminanceSensor_MeasuredValue - zclApp_bh1750IlluminanceSensor_MeasuredValue);
    } else {
      illum = (zclApp_bh1750IlluminanceSensor_MeasuredValue - temp_bh1750IlluminanceSensor_MeasuredValue);
    }
    if (illum > zclApp_Config.MsIlluminanceMinAbsoluteChange || report == 1){ // 10 lux
      temp_bh1750IlluminanceSensor_MeasuredValue = zclApp_bh1750IlluminanceSensor_MeasuredValue;
      bdb_RepChangedAttrValue(zclApp_FourthEP.EndPoint, ILLUMINANCE, ATTRID_MS_ILLUMINANCE_MEASURED_VALUE);
    }
    LREP("bh1750IlluminanceSensor_MeasuredValue value=%d\r\n", zclApp_bh1750IlluminanceSensor_MeasuredValue);
}

//void user_delay_ms(uint32 period) {MicroWait(period * 1000); }

static void zclApp_ReadBME280Temperature(void) {
    uint8 chip = bme280_read8(BME280_REGISTER_CHIPID);
    LREP("BME280_REGISTER_CHIPID=%d\r\n", chip);;
    if (chip == 0x60) {
        bme280_takeForcedMeasurement();
        zclApp_Temperature_Sensor_MeasuredValue = (int16)(bme280_readTemperature() *100);
        LREP("Temperature=%d\r\n", zclApp_Temperature_Sensor_MeasuredValue);
        
        uint16 temp = 0;
        if (temp_Temperature_Sensor_MeasuredValue > zclApp_Temperature_Sensor_MeasuredValue){
          temp = (temp_Temperature_Sensor_MeasuredValue - zclApp_Temperature_Sensor_MeasuredValue);
        } else {
          temp = (zclApp_Temperature_Sensor_MeasuredValue - temp_Temperature_Sensor_MeasuredValue);
        }
        if (temp > zclApp_Config.MsTemperatureMinAbsoluteChange || report == 1){ //50 - 0.5 
          temp_Temperature_Sensor_MeasuredValue = zclApp_Temperature_Sensor_MeasuredValue;
          bdb_RepChangedAttrValue(zclApp_FirstEP.EndPoint, TEMP, ATTRID_MS_TEMPERATURE_MEASURED_VALUE);
        }        
    } else {
        LREPMaster("NOT BME280\r\n");
    }
}

static void zclApp_ReadBME280Pressure(void) {
    uint8 chip = bme280_read8(BME280_REGISTER_CHIPID);
    LREP("BME280_REGISTER_CHIPID=%d\r\n", chip);;
    if (chip == 0x60) {
        bme280_takeForcedMeasurement();
        zclApp_PressureSensor_ScaledValue = (int16) (pow(10.0, (double) zclApp_PressureSensor_Scale) * (double) bme280_readPressure()* 100);

        zclApp_PressureSensor_MeasuredValue = (uint16)bme280_readPressure();
        LREP("Pressure=%d\r\n", zclApp_PressureSensor_MeasuredValue);
                
        uint16 press = 0;
        if (temp_PressureSensor_MeasuredValue > zclApp_PressureSensor_MeasuredValue){
          press = (temp_PressureSensor_MeasuredValue - zclApp_PressureSensor_MeasuredValue);
        } else {
          press = (zclApp_PressureSensor_MeasuredValue - temp_PressureSensor_MeasuredValue);
        }
        if (press > zclApp_Config.MsPressureMinAbsoluteChange || report == 1){ //1gPa
          temp_PressureSensor_MeasuredValue = zclApp_PressureSensor_MeasuredValue; 
          bdb_RepChangedAttrValue(zclApp_FirstEP.EndPoint, PRESSURE, ATTRID_MS_PRESSURE_MEASUREMENT_MEASURED_VALUE);
        }
    } else {
        LREPMaster("NOT BME280\r\n");
    }
}

static void zclApp_ReadBME280Humidity(void) {
    uint8 chip = bme280_read8(BME280_REGISTER_CHIPID);
    LREP("BME280_REGISTER_CHIPID=%d\r\n", chip);;
    if (chip == 0x60) {
        bme280_takeForcedMeasurement();
        zclApp_HumiditySensor_MeasuredValue = (uint16)(bme280_readHumidity() * 100);
        LREP("Humidity=%d\r\n", zclApp_HumiditySensor_MeasuredValue);
                
        uint16 humid = 0;
        if (temp_HumiditySensor_MeasuredValue > zclApp_HumiditySensor_MeasuredValue){
          humid = (temp_HumiditySensor_MeasuredValue - zclApp_HumiditySensor_MeasuredValue);
        } else {
          humid = (zclApp_HumiditySensor_MeasuredValue - temp_HumiditySensor_MeasuredValue);
        }
        if (humid > zclApp_Config.MsHumidityMinAbsoluteChange || report == 1){ //10%
          temp_HumiditySensor_MeasuredValue = zclApp_HumiditySensor_MeasuredValue;
          bdb_RepChangedAttrValue(zclApp_FirstEP.EndPoint, HUMIDITY, ATTRID_MS_RELATIVE_HUMIDITY_MEASURED_VALUE);
        }
    } else {
        LREPMaster("NOT BME280\r\n");
    }
}

static void zclApp_Report(void) { osal_start_reload_timer(zclApp_TaskID, APP_READ_SENSORS_EVT, 100); }

static void zclApp_BasicResetCB(void) {
    LREPMaster("BasicResetCB\r\n");
    zclApp_ResetAttributesToDefaultValues();
    zclApp_SaveAttributesToNV();
}

static ZStatus_t zclApp_ReadWriteAuthCB(afAddrType_t *srcAddr, zclAttrRec_t *pAttr, uint8 oper) {
    LREPMaster("AUTH CB called\r\n");

    osal_start_timerEx(zclApp_TaskID, APP_SAVE_ATTRS_EVT, 2000);
    return ZSuccess;
}

static void zclApp_SaveAttributesToNV(void) {
    uint8 writeStatus = osal_nv_write(NW_APP_CONFIG, 0, sizeof(application_config_t), &zclApp_Config);
    LREP("Saving attributes to NV write=%d\r\n", writeStatus);
    zclApp_bh1750setMTreg();
    zclApp_StopReloadTimer();
    zclApp_StartReloadTimer();
}

static void zclApp_StopReloadTimer(void) {
    osal_stop_timerEx(zclApp_TaskID, APP_REPORT_BATTERY_EVT);
    osal_clear_event(zclApp_TaskID, APP_REPORT_BATTERY_EVT);    
  
    if (bmeDetect == 1){
      osal_stop_timerEx(zclApp_TaskID, APP_REPORT_TEMPERATURE_EVT);
      osal_clear_event(zclApp_TaskID, APP_REPORT_TEMPERATURE_EVT);
      osal_stop_timerEx(zclApp_TaskID, APP_REPORT_PRESSURE_EVT);
      osal_clear_event(zclApp_TaskID, APP_REPORT_PRESSURE_EVT);
      osal_stop_timerEx(zclApp_TaskID, APP_REPORT_HUMIDITY_EVT);
      osal_clear_event(zclApp_TaskID, APP_REPORT_HUMIDITY_EVT);
    }
    if (bh1750Detect == 1){
      osal_stop_timerEx(zclApp_TaskID, APP_REPORT_ILLUMINANCE_EVT);
      osal_clear_event(zclApp_TaskID, APP_REPORT_ILLUMINANCE_EVT);
    }
    if (LumDetect == 1){
      osal_stop_timerEx(zclApp_TaskID, APP_REPORT_LDR_EVT);
      osal_clear_event(zclApp_TaskID, APP_REPORT_LDR_EVT);
    }
}

static void zclApp_StartReloadTimer(void) {
    osal_start_reload_timer(zclApp_TaskID, APP_REPORT_BATTERY_EVT, (uint32)zclApp_Config.CfgBatteryPeriod * 60000);
    
    if (bmeDetect == 1){
      osal_start_reload_timer(zclApp_TaskID, APP_REPORT_TEMPERATURE_EVT, (uint32)zclApp_Config.MsTemperaturePeriod * 1000);
      osal_start_reload_timer(zclApp_TaskID, APP_REPORT_PRESSURE_EVT, (uint32)zclApp_Config.MsPressurePeriod * 1000);
      osal_start_reload_timer(zclApp_TaskID, APP_REPORT_HUMIDITY_EVT, (uint32)zclApp_Config.MsHumidityPeriod * 1000);
    }
    if (bh1750Detect == 1){
      osal_start_reload_timer(zclApp_TaskID, APP_REPORT_ILLUMINANCE_EVT, (uint32)zclApp_Config.MsIlluminancePeriod * 1000);
    } 
    if (LumDetect == 1){
      osal_start_reload_timer(zclApp_TaskID, APP_REPORT_LDR_EVT, (uint32)zclApp_Config.MsIlluminancePeriod * 1000);
    }
}

static void zclApp_RestoreAttributesFromNV(void) {
    uint8 status = osal_nv_item_init(NW_APP_CONFIG, sizeof(application_config_t), NULL);
    LREP("Restoring attributes from NV  status=%d \r\n", status);
    if (status == NV_ITEM_UNINIT) {
        uint8 writeStatus = osal_nv_write(NW_APP_CONFIG, 0, sizeof(application_config_t), &zclApp_Config);
        LREP("NV was empty, writing %d\r\n", writeStatus);
    }
    if (status == ZSUCCESS) {
        LREPMaster("Reading from NV\r\n");
        osal_nv_read(NW_APP_CONFIG, 0, sizeof(application_config_t), &zclApp_Config);
    }
}

static void zclApp_bh1750setMTreg(void) {
    if (bh1750Detect == 1){
      uint8 MTreg = (uint8)zclApp_Config.MsIlluminanceLevelSensingSensitivity;
      bh1750_setMTreg(MTreg);
    }
}

/****************************************************************************
****************************************************************************/
