koptserg/motion/zstack-lib/bettery.c

#include "Debug.h"
#include "battery.h"
#include "hal_adc.h"
#include "utils.h"
#include "OSAL.h"
#include "zcl.h"
#include "zcl_general.h"
#include "bdb_interface.h"
// (( 3 * 1.15 ) / (( 2^14 / 2 ) - 1 )) * 1000 (not correct)
// #define MULTI (float) 0.4211939934
// this coefficient calculated using
// https://docs.google.com/spreadsheets/d/1qrFdMTo0ZrqtlGUoafeB3hplhU3GzDnVWuUK4M9OgNo/edit?usp=sharing
#define MULTI (float)0.443

#define VOLTAGE_MIN 2.0
#define VOLTAGE_MAX 3.3

#ifndef ZCL_BATTERY_REPORT_INTERVAL
    #define ZCL_BATTERY_REPORT_INTERVAL ((uint32) 1800000) //30 minutes
#endif

#ifndef ZCL_BATTERY_REPORT_DELAY
    #define ZCL_BATTERY_REPORT_DELAY 5 * 1000
#endif

#ifndef ZCL_BATTERY_REPORT_REPORT_CONVERTER
#define ZCL_BATTERY_REPORT_REPORT_CONVERTER(millivolts) getBatteryRemainingPercentageZCLCR2032(millivolts)
#endif

#define POWER_CFG ZCL_CLUSTER_ID_GEN_POWER_CFG

#define ZCL_BATTERY_REPORT_EVT 0x0001


uint8 zclBattery_Voltage = 0xff;
uint8 zclBattery_PercentageRemainig = 0xff;
uint16 zclBattery_RawAdc = 0xff;

uint8 getBatteryVoltageZCL(uint16 millivolts) {
    uint8 volt8 = (uint8)(millivolts / 100);
    if ((millivolts - (volt8 * 100)) > 50) {
        return volt8 + 1;
    } else {
        return volt8;
    }
}
// return millivolts
uint16 getBatteryVoltage(void) {
    HalAdcSetReference(HAL_ADC_REF_125V);
    zclBattery_RawAdc = adcReadSampled(HAL_ADC_CHANNEL_VDD, HAL_ADC_RESOLUTION_14, HAL_ADC_REF_125V, 10);
    return (uint16)(zclBattery_RawAdc * MULTI);
}

uint8 getBatteryRemainingPercentageZCL(uint16 millivolts) { return (uint8)mapRange(VOLTAGE_MIN, VOLTAGE_MAX, 0.0, 200.0, millivolts); }

uint8 getBatteryRemainingPercentageZCLCR2032(uint16 volt16) {
    float battery_level;
    if (volt16 >= 3000) {
        battery_level = 100;
    } else if (volt16 > 2900) {
        battery_level = 100 - ((3000 - volt16) * 58) / 100;
    } else if (volt16 > 2740) {
        battery_level = 42 - ((2900 - volt16) * 24) / 160;
    } else if (volt16 > 2440) {
        battery_level = 18 - ((2740 - volt16) * 12) / 300;
    } else if (volt16 > 2100) {
        battery_level = 6 - ((2440 - volt16) * 6) / 340;
    } else {
        battery_level = 0;
    }
    return (uint8)(battery_level * 2);
}

void zclBattery_Report(void) {
    uint16 millivolts = getBatteryVoltage();
    zclBattery_Voltage = getBatteryVoltageZCL(millivolts);
    zclBattery_PercentageRemainig = ZCL_BATTERY_REPORT_REPORT_CONVERTER(millivolts);

    LREP("Battery voltageZCL=%d prc=%d voltage=%d\r\n", zclBattery_Voltage, zclBattery_PercentageRemainig, millivolts);

#if BDB_REPORTING
    bdb_RepChangedAttrValue(1, POWER_CFG, ATTRID_POWER_CFG_BATTERY_PERCENTAGE_REMAINING);
#else
    const uint8 NUM_ATTRIBUTES = 3;
    zclReportCmd_t *pReportCmd;
    pReportCmd = osal_mem_alloc(sizeof(zclReportCmd_t) + (NUM_ATTRIBUTES * sizeof(zclReport_t)));
    if (pReportCmd != NULL) {
        pReportCmd->numAttr = NUM_ATTRIBUTES;

        pReportCmd->attrList[0].attrID = ATTRID_POWER_CFG_BATTERY_VOLTAGE;
        pReportCmd->attrList[0].dataType = ZCL_DATATYPE_UINT8;
        pReportCmd->attrList[0].attrData = (void *)(&zclBattery_Voltage);

        pReportCmd->attrList[1].attrID = ATTRID_POWER_CFG_BATTERY_PERCENTAGE_REMAINING;
        pReportCmd->attrList[1].dataType = ZCL_DATATYPE_UINT8;
        pReportCmd->attrList[1].attrData = (void *)(&zclBattery_PercentageRemainig);

        pReportCmd->attrList[2].attrID = ATTRID_POWER_CFG_BATTERY_VOLTAGE_RAW_ADC;
        pReportCmd->attrList[2].dataType = ZCL_DATATYPE_UINT16;
        pReportCmd->attrList[2].attrData = (void *)(&zclBattery_RawAdc);

        afAddrType_t inderect_DstAddr = {.addrMode = (afAddrMode_t)AddrNotPresent, .endPoint = 0, .addr.shortAddr = 0};
        zcl_SendReportCmd(1, &inderect_DstAddr, POWER_CFG, pReportCmd, ZCL_FRAME_CLIENT_SERVER_DIR, TRUE, bdb_getZCLFrameCounter());
    }
    osal_mem_free(pReportCmd);
#endif
}

uint8 zclBattery_TaskId = 0;

void zclBattery_Init(uint8 task_id) {
    zclBattery_TaskId = task_id;
#if BDB_REPORTING
    osal_start_reload_timer(zclBattery_TaskId, ZCL_BATTERY_REPORT_EVT, ZCL_BATTERY_REPORT_INTERVAL);
#endif
}

uint16 zclBattery_event_loop(uint8 task_id, uint16 events) {
    LREP("zclBattery_event_loop 0x%X\r\n", events);
    if (events & ZCL_BATTERY_REPORT_EVT) {
        LREPMaster("ZCL_BATTERY_REPORT_EVT\r\n");
        zclBattery_Report();
        return (events ^ ZCL_BATTERY_REPORT_EVT);
    }
    return 0;
}

void zclBattery_HandleKeys(uint8 portAndAction, uint8 keyCode) {
    osal_start_timerEx(zclBattery_TaskId, ZCL_BATTERY_REPORT_EVT, ZCL_BATTERY_REPORT_DELAY);
}
